EEEUoMgroup22/Group-22/Meeting Minutes/Semester 1/WhatsApp Image 2018-10-06 at 21.18.59.jpeg

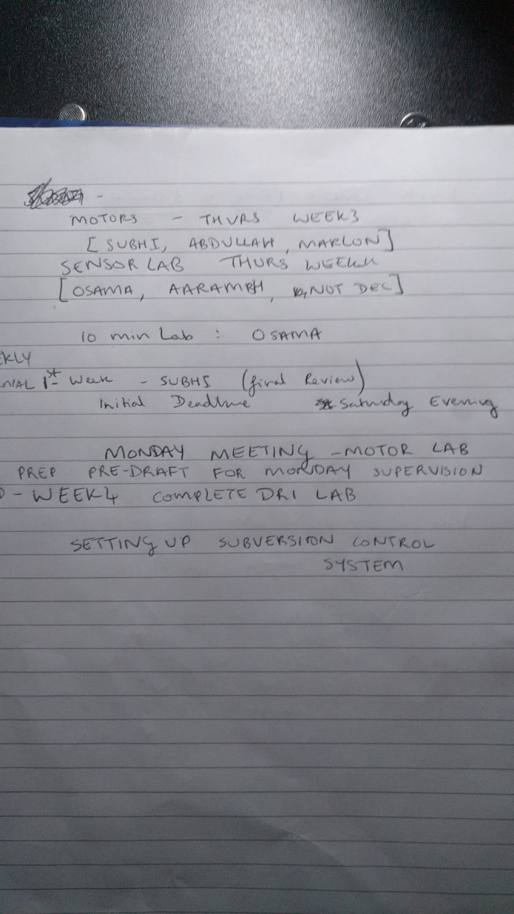
Meeting Minutes/Semester 1/WhatsApp Image 2018-10-06 at 21.18.59.jpeg
