EEEUoMgroup22/Group-22/Design Report 1/Final Draft/Sections Templates/Marlon and Aarambh/Graphs%20(1).xlsx

Sheet: I vs V
N | I | V
1 | 1.31 | 3.119
2 | 1.16 | 2.843
3 | 1.09 | 2.618
4 | 0.91 | 2.453
5 | 0.8 | 2.242
6 | 0.7 | 2.01
7 | 0.61 | 1.82
8 | 0.52 | 1.61
9 | 0.44 | 1.409
10 | 0.36 | 1.213
11 | 0.31 | 1.03
12
13
 | I | V
 | 0.1 | 0.00878
 | 0.2 | 0.019
 | 0.3 | 0.02797
 | 0.4 | 0.037
 | 0.5 | 0.04743
 | 0.6 | 0.05698
 | 0.7 | 0.0643
 | 0.8 | 0.07534
 | 0.9 | 0.08351
 | 1 | 0.09265

Sheet: T vs I, T vs spd and Emf vs spd
N | Motor current I(A) | F1(N) | F2(N) | Voltage V at the motor (V) | Motor speed (rpm) | Torque (Nm) T=(F1-F2)x0.5d | Motor emf (V) E=V-Vb-IxR | d (m) | Vb (V) | R (Ω) | Motor speed (rps)
1 | 1.31 | 2.5 | 0.8 | 3.119 |  | 0.0085 | 3.119 | 0.01 |  |  | 0
2 | 1.16 | 2.1 | 0.7 | 2.843 |  | 0.007 | 2.843 |  |  |  | 0
3 | 1.09 | 2.1 | 0.7 | 2.618 |  | 0.007 | 2.618 |  |  |  | 0
4 | 0.91 | 1.7 | 0.6 | 2.453 |  | 0.0055 | 2.453 |  |  |  | 0
5 | 0.8 | 1.7 | 0.6 | 2.242 |  | 0.0055 | 2.242 |  |  |  | 0
6 | 0.7 | 1.3 | 0.5 | 2.01 |  | 0.004 | 2.01 |  |  |  | 0
7 | 0.61 | 1.1 | 0.4 | 1.82 |  | 0.0035 | 1.82 |  |  |  | 0
8 | 0.52 | 1 | 0.4 | 1.61 |  | 0.003 | 1.61 |  |  |  | 0
9 | 0.44 | 0.8 | 0.35 | 1.409 |  | 0.00225 | 1.409 |  |  |  | 0
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
