EEEUoMgroup22/Group-22/Design Report 1/Final Draft/Sections Templates/Marlon and Aarambh/Graphs.xlsx

Sheet: I vs V
N | I | V | 0.2
1 | 0.34 | 0.956
2 | 0.44 | 1.243
3 | 0.55 | 1.497
4 | 0.66 | 1.748
5 | 0.76 | 2.028
6 | 0.86 | 2.257
7 | 0.99 | 2.546
8 | 1.1 | 2.73
9 | 1.19 | 3.053
10 | 1.28 | 3.247
11 | 1.37 | 3.517
12
13

Sheet: T vs I, T vs spd and Emf vs spd
N | Motor current I(A) | F1(N) | F2(N) | Voltage V at the motor (V) | Motor speed (rpm) | Torque (Nm) T=(F1-F2)x0.5d | Motor emf (V) E=V-Vb-IxR | d (m) | Vb (V) | R (Ω) | Motor speed (rps)
1 | 0.14 | 0 | 0 | 5 | 4890 | 0 | 4.504246 | 0.01 | 0.1568 | 2.4211 | 512.0796025
2 | 0.24 | 0.2 | 0 | 5 | 4656 | 0.001 | 4.262136 |  |  |  | 487.5751798
3 | 0.35 | 0.4 | 0 | 5 | 4300 | 0.002 | 3.995815 |  |  |  | 450.294947
4 | 0.49 | 0.6 | 0 | 5 | 3947 | 0.003 | 3.656861 |  |  |  | 413.3288735
5 | 0.62 | 0.8 | 0 | 5 | 3642 | 0.004 | 3.342118 |  |  |  | 381.3893481
6 | 0.69 | 1 | 0 | 5 | 3582 | 0.005 | 3.172641 |  |  |  | 375.1061628
7 | 0.84 | 1.2 | 0 | 5 | 3220 | 0.006 | 2.809476 |  |  |  | 337.1976115
8 | 1.02 | 1.4 | 0 | 5 | 2776 | 0.007 | 2.373678 |  |  |  | 290.7020402
9 | 1.12 | 1.6 | 0 | 5 | 2546 | 0.008 | 2.131568 |  |  |  | 266.6164965
10 | 1.23 | 1.8 | 0 | 5 | 2221 | 0.009 | 1.865247 |  |  |  | 232.5825761
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
