EEEUoMgroup22/Group-22/Meeting Minutes/Semester 1/WhatsApp Image 2018-10-15 at 13.46.34.jpeg

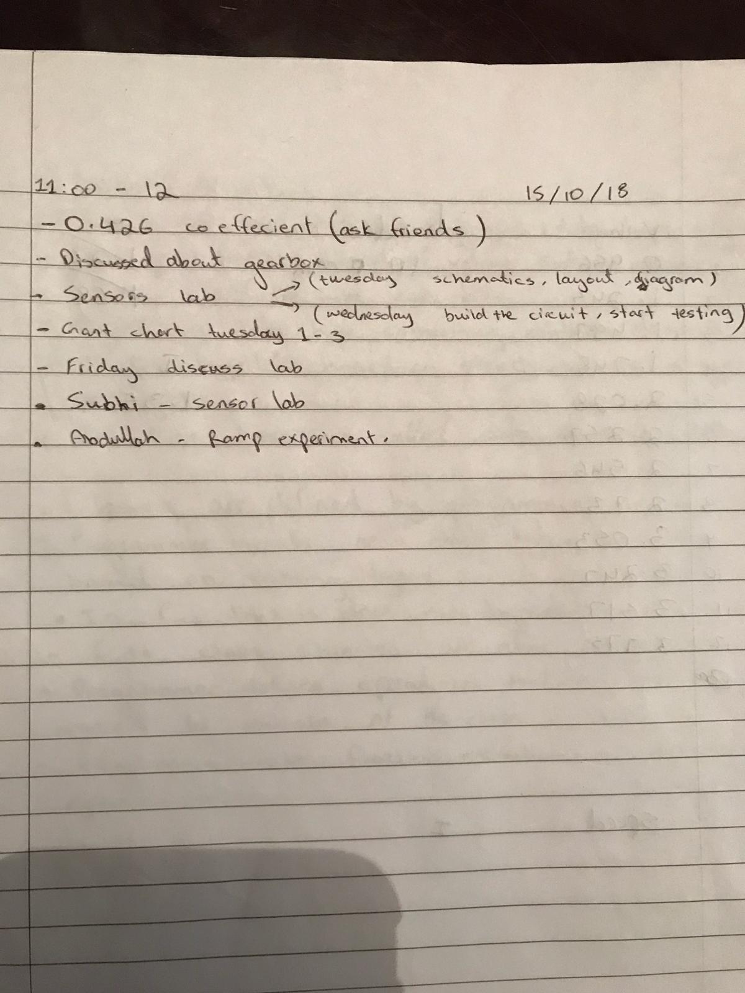
Meeting Minutes/Semester 1/WhatsApp Image 2018-10-15 at 13.46.34.jpeg
