EEEUoMgroup22/Group-22/Meeting Minutes/Semester 1/WhatsApp Image 2018-10-22 at 21.10.34.jpeg

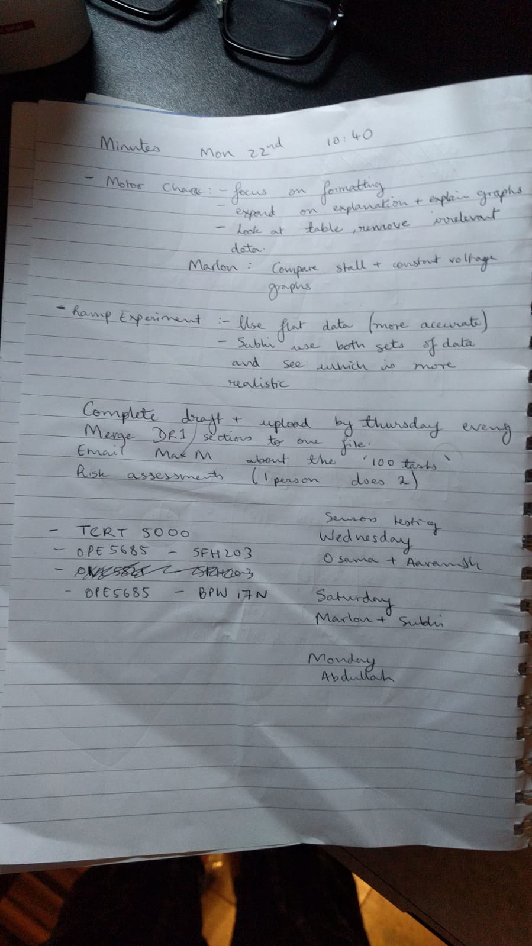
Meeting Minutes/Semester 1/WhatsApp Image 2018-10-22 at 21.10.34.jpeg
