EEEUoMgroup22/Group-22/Meeting Minutes/Semester 1/WhatsApp Image 2018-10-26 at 12.54.49.jpeg

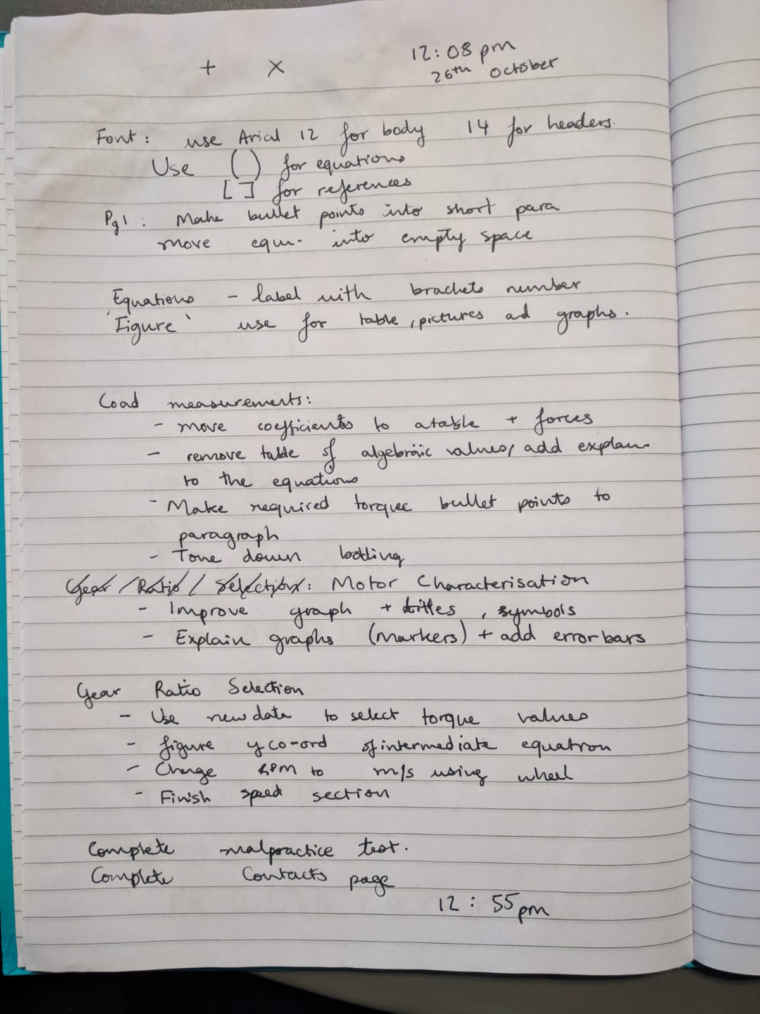
Meeting Minutes/Semester 1/WhatsApp Image 2018-10-26 at 12.54.49.jpeg
