EEEUoMgroup22/Group-22/Meeting Minutes/Semester 1/WhatsApp Image 2018-10-29 at 18.27.18.jpeg

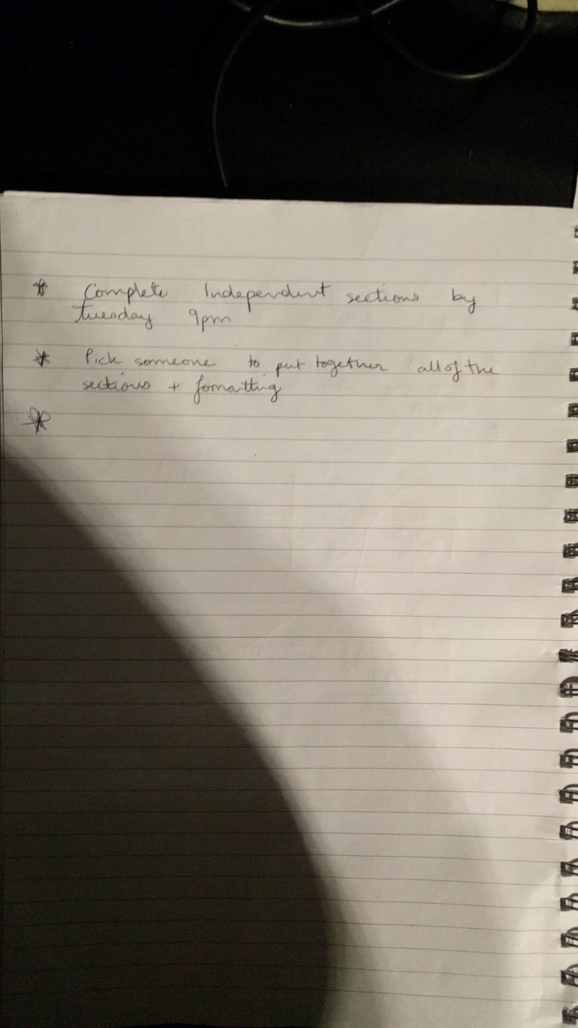
Meeting Minutes/Semester 1/WhatsApp Image 2018-10-29 at 18.27.18.jpeg
