EEEUoMgroup22/Group-22/Meeting Minutes/Semester 1/WhatsApp Image 2018-10-31 at 15.00.20.jpeg

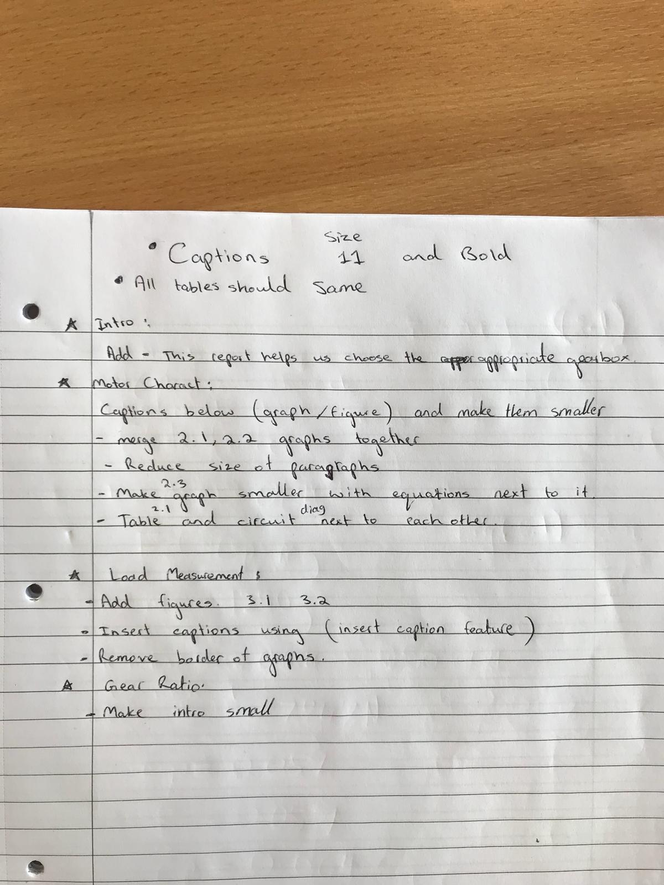
Meeting Minutes/Semester 1/WhatsApp Image 2018-10-31 at 15.00.20.jpeg
