EEEUoMgroup22/Group-22/Meeting Minutes/Semester 1/WhatsApp Image 2018-11-04 at 10.54.24.jpeg

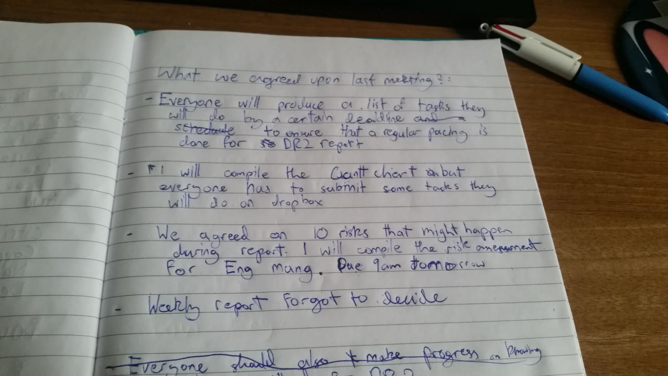
Meeting Minutes/Semester 1/WhatsApp Image 2018-11-04 at 10.54.24.jpeg
