EEEUoMgroup22/Group-22/Meeting Minutes/Semester 1/WhatsApp Image 2018-11-05 at 19.45.11.jpeg

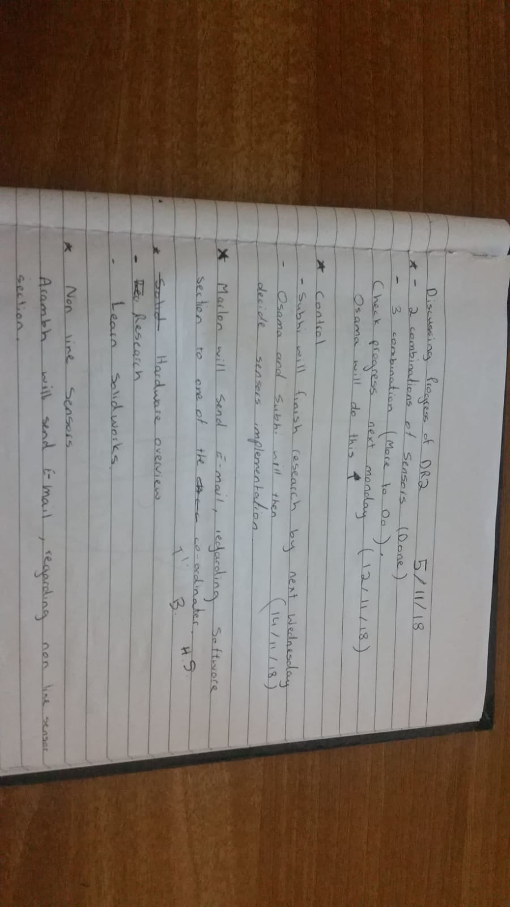
Meeting Minutes/Semester 1/WhatsApp Image 2018-11-05 at 19.45.11.jpeg
