EEEUoMgroup22/Group-22/Meeting Minutes/Semester 1/WhatsApp Image 2018-11-17 at 12.28.48.jpeg

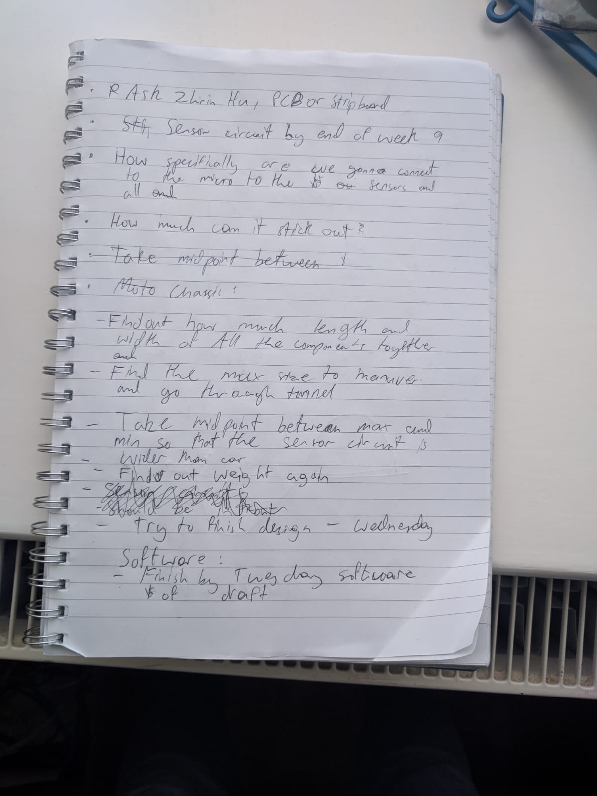
Meeting Minutes/Semester 1/WhatsApp Image 2018-11-17 at 12.28.48.jpeg
