EEEUoMgroup22/Group-22/Meeting Minutes/Semester 1/WhatsApp Image 2018-11-23 at 21.00.41.jpeg

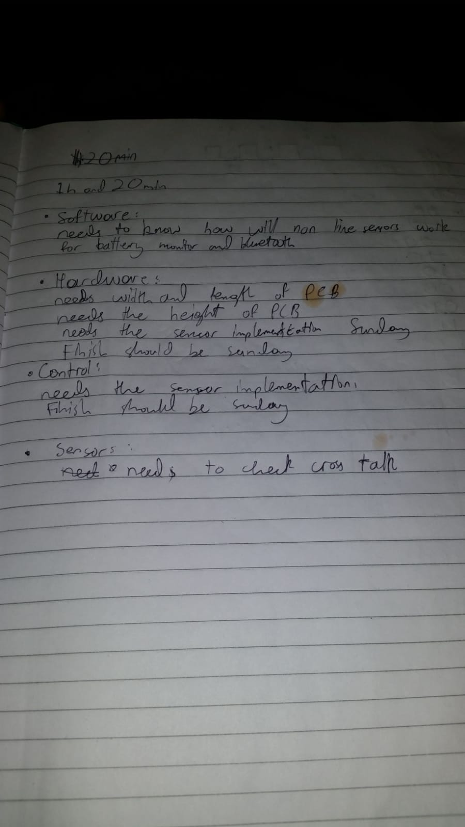
Meeting Minutes/Semester 1/WhatsApp Image 2018-11-23 at 21.00.41.jpeg
