EEEUoMgroup22/Group-22/Meeting Minutes/Semester 1/WhatsApp Image 2018-11-25 at 00.08.05.jpeg

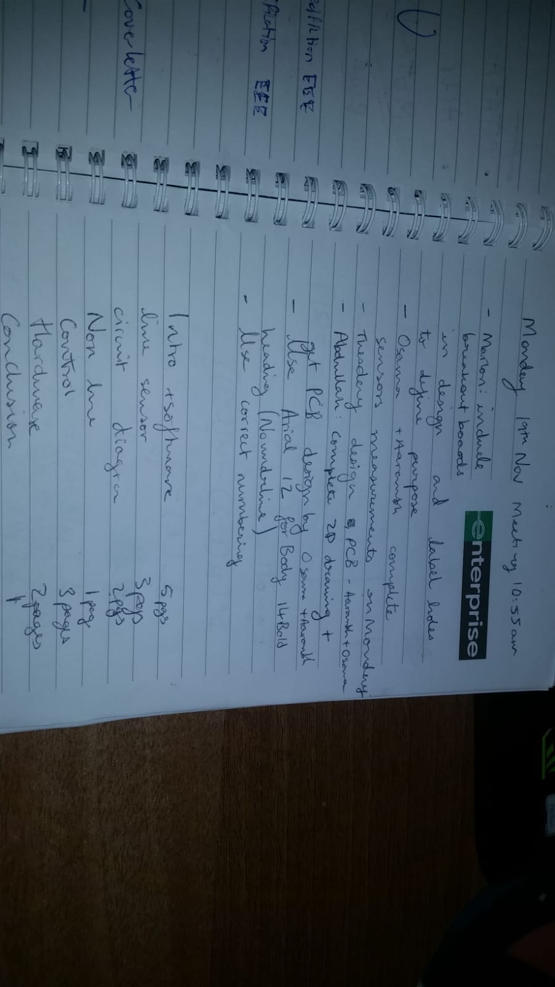
Meeting Minutes/Semester 1/WhatsApp Image 2018-11-25 at 00.08.05.jpeg
