EEEUoMgroup22/Group-22/Meeting Minutes/Semester 1/WhatsApp Image 2018-12-02 at 17.14.09.jpeg

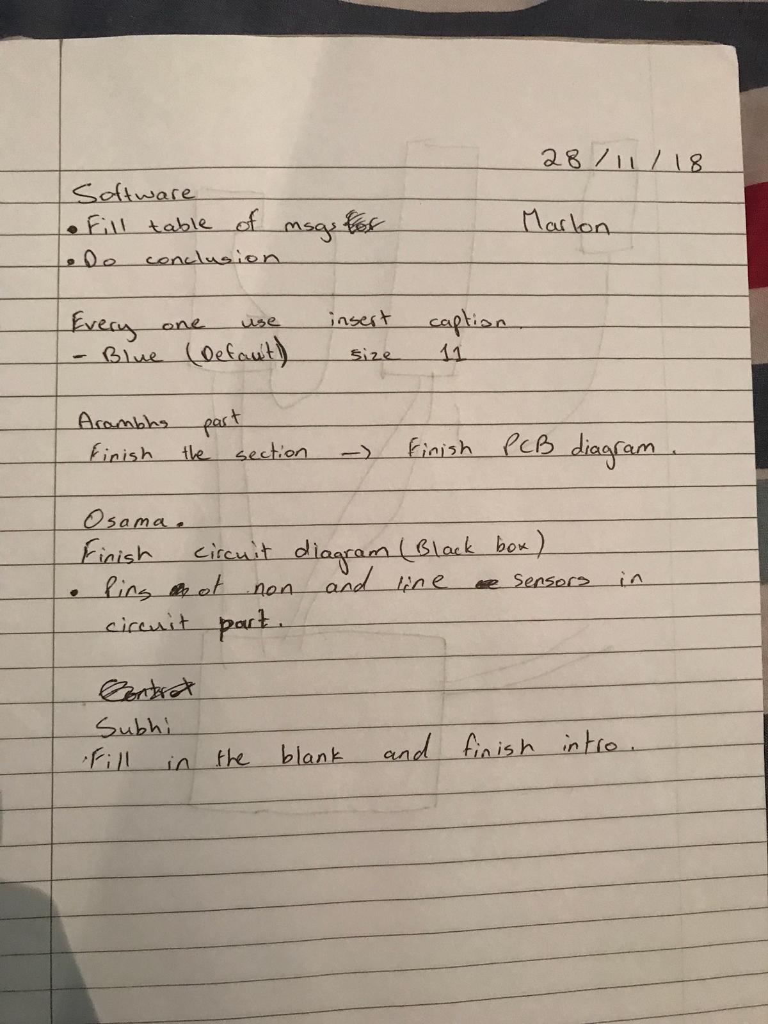
Meeting Minutes/Semester 1/WhatsApp Image 2018-12-02 at 17.14.09.jpeg
