EEEUoMgroup22/Group-22/Meeting Minutes/Semester 2/20190131_141448.jpg

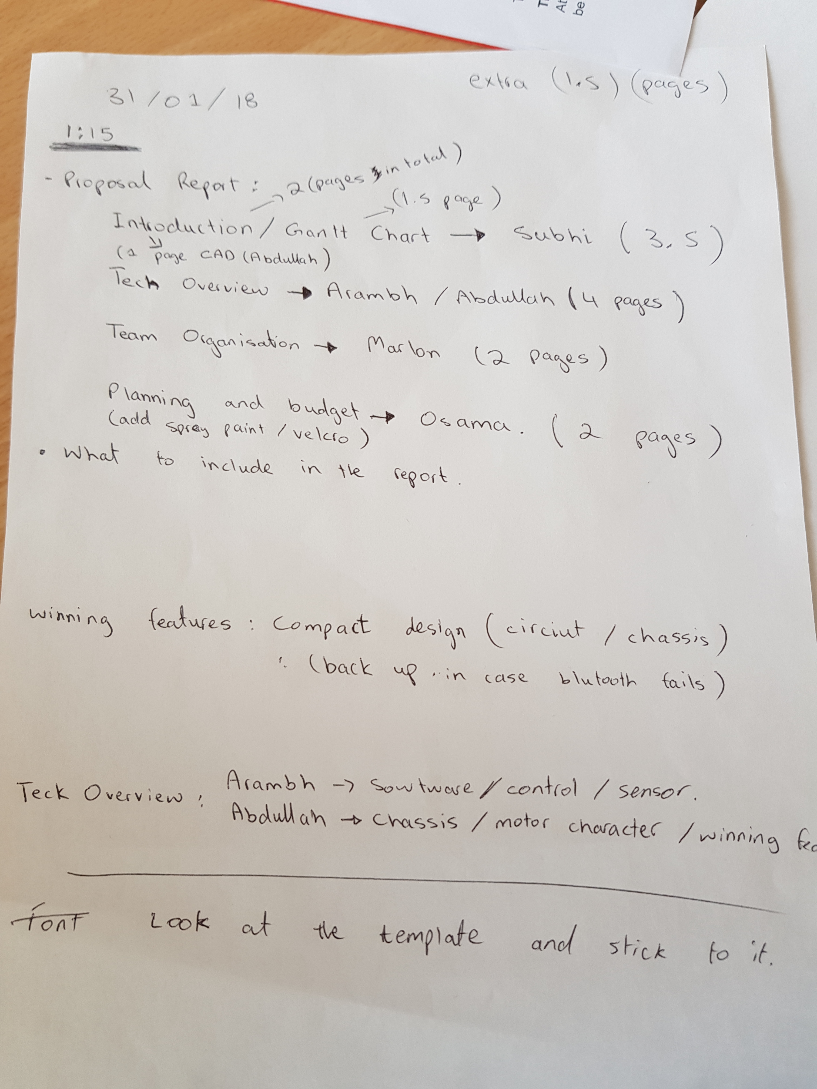
Meeting Minutes/Semester 2/20190131_141448.jpg
