EEEUoMgroup22/Group-22/Meeting Minutes/Semester 2/20190204_115247.jpg

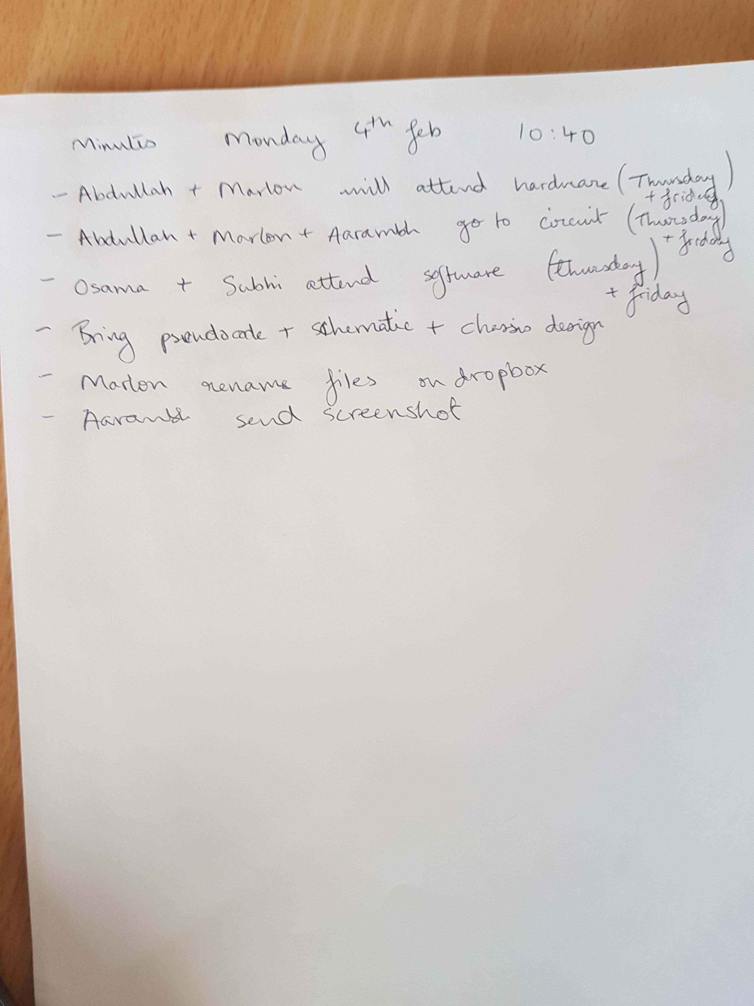
Meeting Minutes/Semester 2/20190204_115247.jpg
