EEEUoMgroup22/Group-22/Other documents/people who won buggy race.PNG

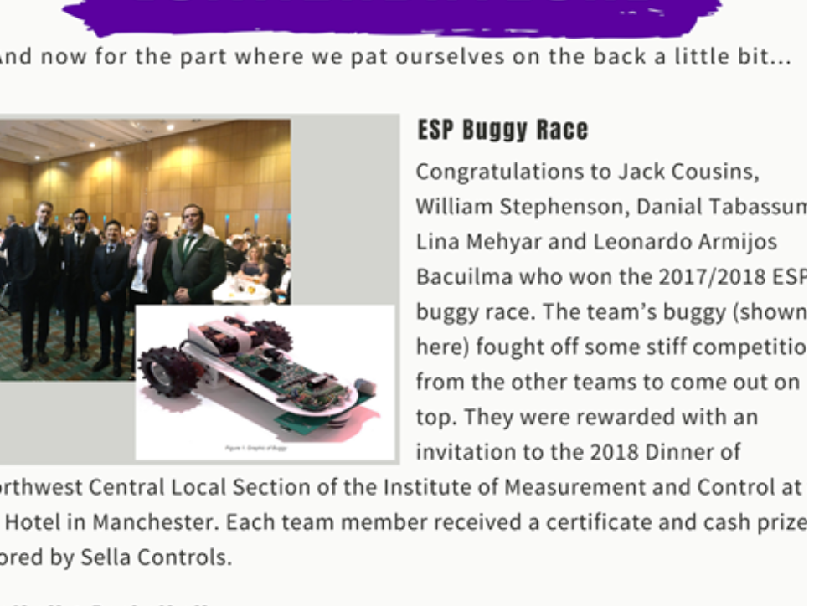
Other documents/people who won buggy race.PNG
