EEEUoMgroup22/Group-22/Technical Datasheets/HM-10_Circuit_001_800-595x400.jpg

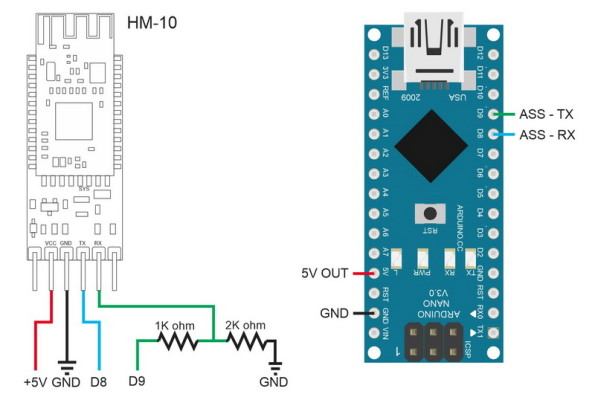
Technical Datasheets/HM-10_Circuit_001_800-595x400.jpg
