EEEUoMgroup22/Group-22/Proposal Report/Budget for Proposal.xlsx

Item category | Item Manu. Part | Quantity needed | Cost per component (£) | Difference between total cost and budget given | sum total
Populated PCB | NUCLEO -F401RE | 1 | 15 | 15
 | Controller board | 1 | 30 | 30
Integrated Circuits | LM339 | 1 | 0.64 | 0.64
 | ULN2003 | 1 | 0.23 | 0.23
Unpopulated PCBs, IC Sockets and Headers | 8 pin IC base | 3 | 0.8 | 2.4
 | 4 way SIL Header | 6 | 0.2 | 1.2
 | Sensor Mini PCBs | 3 | 1 | 3
Sensors | TCRT5000 | 2 | 0.64 | 1.28
 | AEAT-601BF06 | 2 | 16.85 | 33.7
 | HM-10 | 1 | 16.36 | 16.36
Mechanical Parts | Chassis | 1 | 42 | 42
 | Front wheel | 1 | 2.5 | 2.5
 | Rubber tyre | 2 | 1.45 | 2.9
 | Motor B | 2 | 7.11 | 14.22
 | Gear Box | 2 | 7 | 14
 | Jumper cables | 1 | 3 | 3
 | Sensor PCB empty board | 1 | 50 | 50
Misc | Battery Holder | 1 | 3.5 | 3.5
 | Cable ties | 3 | 0.2 | 0.6
 | Batteries | 8 | 2 | 16
Basic electronic parts | resistors | 12 | 0.1 | 1.2
 | Var. resistor | 1 | 0.12 | 0.12 | 253.85
Sensors | TCRT5000 | 4 | 0.64 | 2.56
Unpopulated PCBs, IC Sockets and Headers | 8 pin IC base | 3 | 0.8 | 2.4
 | 4 way SIL Header | 10 | 0.2 | 2
 | Sensor Mini PCBs | 3 | 1 | 3
Integrated circuits | LM339 | 1 | 0.64 | 0.64 | 10.6
 |  |  |  | Total Cost | 264.45
