EEEUoMgroup22/Group-22/proposal/Budget for Proposal.xlsx

Item category | Item Manu. Part | Item description | Quantity needed | Cost per component (£) | total cost of component (£) | Total cost of all components(£)
Free Issue
Populated PCB | NUCLEO -F401RE | STM32F401RE Nucleo Dev. | 1 | 15 | 15
 | Controller board | Motor drive board | 1 | 30 | 30
Integrated Circuits | LM339 | Quad comparator | 1 | 0.64 | 0.64
 | ULN2003 | 7 Elemnet Darlington | 1 | 0.23 | 0.23
Unpopulated PCBs, IC Sockets and Headers | 8 pin IC base | 2.54 mm pitch | 3 | 0.8 | 2.4
 | 4 way SIL Header | 2.54 mm ptich | 6 | 0.2 | 1.2
 | Sensor Mini PCBs | Created at UoM | 3 | 1 | 3
Sensors | TCRT5000 | Reflective Optical Sensor | 2 | 0.64 | 1.28
 | AEAT-601BF06 | Broadcom encoders | 2 | 16.85 | 33.7
 | HM-10 | Bluetooth module | 1 | 16.36 | 16.36
Mechanical Parts | Chassis | 600 x 900 x 3 mm Acetyl Created at UoM | 1 | 42 | 42
 | Front wheel | Ball castor | 1 | 2.5 | 2.5
 | Rubber tyre | 80 mm spiked tyre | 2 | 1.45 | 2.9
 | Motor A | 6-15V 8W DC Brushed |  | 5.14 | 0
 | Motor B | RS Pro DC Motor |  | 7.11 | 0
 | Gear Box | Acetyl box+ gears | 2 | 7 | 14
 | Jumper cables | MM/MF/FF | 1 | 3 | 3
 | Sensor PCB empty board | dimensions | 1 |  | 0
Misc | Battery Holder | Custom with fuse, 8 way | 1 | 3.5 | 3.5
 | Batteries | 1.2V rechargable | 8 | 2 | 16
Basic electronic parts | resistors | Leaded resistors | 12 | 0.1 | 1.2
 | Var. resistor | Variable resistor | 1 | 0.12 | 0.12 | 189.03
Budget
Sensors | TCRT5000 | Reflective Optical Sensor | 3 | 0.64 | 1.92
Unpopulated PCBs, IC Sockets and Headers | 8 pin IC base | 2.54 mm pitch | 3 | 0.8 | 2.4
 | 4 way SIL Header | 2.54 mm ptich | 10 | 0.2 | 2
 | Sensor Mini PCBs | Created at UoM | 3 | 1 | 3
Integrated circuits | LM339 | Quad comparator | 1 | 0.64 | 0.64
Misc | Velcro Order code OE04216 , Onecall | Velcro 12 mm x 380 mm | 1 | 3.05 | 3.05 | 13.01
 | order code 9731180 |  |  |  |  | 202.04
