EEEUoMgroup22/Group-22/Measurements/Sensors Methods and Results/Sensors results/bpw - ope final measurements.xlsx

Sheet: Height experiments
For black part | Distance (mm) | Resistor LED (ohm) | Resistor Trans (ohm) | Voltage Res LED (V) | Voltage VDD LED (V) | Current LED (A) | Voltage Res Trans (V) | Voltage Collector Emitter VDD (V) | Current Trans (A) | Power (W) | Wasted Power (W) | Overall Efficiency | Technical results
1 | -2 | 33 | 100000 | 3 | 2 | 0.06060606061 |  | 5 | 0 | 0.303030303 | 0.1212121212 | 60 | Height of Transistor from stripboard | 0 | Column1
2 | 3 | 33 | 100000 | 3 | 2 | 0.06060606061 | 0.0864 | 4.9136 | 8.64e-07 | 0.303034623 | 0.1212121959 | 60.0005456 | Height of first increment | 16mm | 16mm
3 | 8 | 33 | 100000 | 3 | 2 | 0.06060606061 | 0.464 | 4.536 | 4.64e-06 | 0.303053503 | 0.1212142742 | 60.00235174 | Each increment | 5mm | 5mm
4 | 13 | 33 | 100000 | 3 | 2 | 0.06060606061 | 0.395 | 4.605 | 3.95e-06 | 0.303050053 | 0.1212136815 | 60.00209198
5 | 18 | 33 | 100000 | 3 | 2 | 0.06060606061 | 0.327 | 4.673 | 3.27e-06 | 0.303046653 | 0.1212131905 | 60.00180524 | LED | Column2 | Column3
6 | 23 | 33 | 100000 | 3 | 2 | 0.06060606061 | 0.253 | 4.747 | 2.53e-06 | 0.303042953 | 0.1212127613 | 60.00145851 | Voltage VDD LED (V)
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
