EEEUoMgroup22/Group-22/Measurements/Sensors Methods and Results/Sensors results/compiled sensors data.xlsx

Sheet: Sheet1
Height Measurements | OVL5521 - VT90N2 at 10,000 at black | OVL5521 - VT90N2 at 10,000 at white |  | TCRT5000 4K7 | TCRT WHITE |  | OPE VTN black |  | OPE5685 SFH BLACK | OPE SFH WHITE | OPE BPW |  | TCRT10K |  | tcrt black min | tcrt black max |  |  |  |  | TCRT5000 CROSSTALK BLACK
0 | 1.274 | 3.1 |  | 0.0053 | 0.433 |  | 1.948 | 3.205 | 0.813 | 4.91 | 0.0864 | 1.424 |  |  |  |  |  |  | negative | positive | 0.0727 | 2.72
4 | 2.12 | 4.2 |  | 0.06 | 4 |  | 1.868 | 3.249 | 0.646 | 4.91 | 0.464 | 4.42 | 0.94444 | 4.42476 | 0.9364 | 0.954 | 4.4244 | 4.425 | 0.00828 | 0.00992 | 0.1456 | 4.398
9 | 2.27 | 4.1 |  | 0.095 | 3.74 |  | 2.0827 | 3.413 | 0.499 | 4.64 | 0.395 | 4.26 | 0.431786 | 4.3825 | 0.42918 | 0.4331 | 4.3822 | 4.3827 | 0.002806 | 0.001614 | 0.04957 | 2.4702
14 | 1.98 | 3.96 |  | 0.0267 | 1.4 |  | 2.717 | 3.315 | 0.436 | 3.04 | 0.327 | 3.51 | 0.2273 | 3.23758 | 0.2246 | 0.2283 | 3.219 | 3.2476 | 0.01272 | 0.01958 | 0.01949 | 1.011
19 | 2.4 | 3.82 |  | 0.01 | 0.565 |  | 2.831 | 3.268 | 0.404 | 2.05 | 0.253 | 2.64 | 0.14142 | 1.90036 | 0.1406 | 0.1421 | 1.8905 | 1.9103 | 0.01076 | 0.01054 | 0.0111 | 0.4804
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
