EEEUoMgroup22/Group-22/Measurements/Sensors Methods and Results/Sensors results/ope5685 and vtn final measurements (2) completed.xlsx

Sheet: Height experiments
For black part | Distance (mm) | Resistor LED (ohm) | Resistor Trans (ohm) | Voltage Res LED (V) | Voltage VDD LED (V) | Current LED (A) | Voltage Res Trans (V) | Voltage Collector Emitter VDD (V) | Current Trans (A) | Power (W) | Wasted Power (W) | Overall Efficiency | Technical results
 | 0 | 33 | 8170 | 3.1386 | 1.8614 | 0.05640606061 |  | 3.132 | 0.0002286413709 | 0.2831735099 | 0.1054213433 | 62.7714671 | Height of Transistor from stripboard | 0 | Column1
 | 1 | 33 | 8170 | 3.1386 | 1.8614 | 0.05640606061 | 1.948 | #REF! | #REF! | #REF! | #REF! | #REF! | Height of first increment | 16mm | 16mm
 | 6 | 33 | 8170 | 3.1386 | 1.8614 | 0.05640606061 | 1.868 | 2.9173 | 0.0002549204406 | 0.2833049052 | 0.105525164 | 62.75208722 | Each increment | 5mm | 5mm
 | 11 | 33 | 8170 | 3.1386 | 1.8614 | 0.05640606061 | 2.0827 | 2.283 | 0.0003325581395 | 0.2836930937 | 0.1058978017 | 62.67170262
 | 16 | 33 | 8170 | 3.1386 | 1.8614 | 0.05640606061 | 2.717 | 2.169 | 0.0003465116279 | 0.2837628612 | 0.1059752156 | 62.65359914 | LED | Column2 | Column3
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
