EEEUoMgroup22/Group-22/Measurements/Sensors Methods and Results/Sensors results/OPE5685 SFH203 FINAL MEASUREMENTS.xlsx

Sheet: Height experiments
For black part | Distance from transistor to black plate (mm) | Resistor LED (ohm) | Resistor Trans (ohm) | Voltage Res LED (V) | Voltage VDD LED (V) | Current LED (A) | Voltage Res Trans (V) | Voltage Collector Emitter VDD (V) | Current Trans (A) | Power (W) | Wasted Power (W) | Overall Efficiency | Technical results
 | -3 | 33 | 470000 | 3.1 | 1.9 | 0.05757575758 |  | 5 | 0 | 0.2878787879 | 0.1093939394 | 62 | Height of Transistor from stripboard | 0 | Column1
 | 4 | 33 | 470000 | 3.1 | 1.9 | 0.05757575758 | 0.813 | 4.187 | 1.729787234e-06 | 0.2878874368 | 0.1093953457 | 62.00065313 | Height of first increment | 16mm | 16mm
 | 9 | 33 | 470000 | 3.1 | 1.9 | 0.05757575758 | 0.646 | 4.354 | 1.374468085e-06 | 0.2878856602 | 0.1093948273 | 62.0005987 | Each increment | 5mm | 5mm
 | 14 | 33 | 470000 | 3.1 | 1.9 | 0.05757575758 | 0.499 | 4.501 | 1.061702128e-06 | 0.2878840964 | 0.1093944692 | 62.00051668
 | 19 | 33 | 470000 | 3.1 | 1.9 | 0.05757575758 | 0.436 | 4.564 | 9.276595745e-07 | 0.2878834262 | 0.1093943439 | 62.00047175 | LED | Column2 | Column3
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
