EEEUoMgroup22/Group-22/Measurements/Sensors Methods and Results/Sensors results/OVL -vt90n2.xlsx

Sheet: Height experiments
For black part | Distance (mm) | Resistor LED (ohm) | Resistor Trans (ohm) | Voltage Res LED (V) | Voltage VDD LED (V) | Current LED (A) | Voltage Res Trans (V) | Voltage Collector Emitter VDD (V) | Current Trans (A) | Power (W) | Wasted Power (W) | Overall Efficiency | Technical results
 | 0 | 62 | 10000 | 1.81 |  |  |  |  | 0 | 0 | 0 | #DIV/0! | Height of Transistor from stripboard | 0 | Column1
 | 4 | 62 | 10000 | 1.81 |  |  |  |  | 0 | 0 | 0 | #DIV/0! | Height of first increment | 16mm | 16mm
 | 9 | 62 | 10000 | 1.81 | 3.19 | 0.02919354839 | 1.274 | 3.726 | 0.0001274 | 0.1466047419 | 0.05300263018 | 63.84657858 | Each increment | 5mm | 5mm
 | 14 | 62 | 10000 | 1.81 | 3.19 | 0.02919354839 | 2.12 | 2.88 | 0.000212 | 0.1470277419 | 0.05328976258 | 63.75530095
 | 19 | 62 | 10000 | 1.81 | 3.19 | 0.02919354839 | 2.27 | 2.73 | 0.000227 | 0.1471027419 | 0.05335561258 | 63.7290156 | LED | Column2 | Column3
 | 24 | 62 | 10000 | 1.81 | 3.19 | 0.02919354839 | 1.98 | 3.02 | 0.000198 | 0.1469577419 | 0.05323236258 | 63.77709546 | Voltage VDD LED (V) | 5
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
