EEEUoMgroup22/Group-22/Measurements/Sensors Methods and Results/Sensors results/TCRT5000 10KCOMPLETED.xlsx

Sheet: height black
Distance (mm) | Resistor LED (ohm) | Resistor Trans (ohm) | Voltage Res LED (V) | Voltage LED (V) | Current LED (A) | Voltage Res Trans (V) | Voltage Collector Emitter (V) | Current Trans (A) | Power (W) | Wasted Power (W) | Overall Efficiency | white line | Voltage Res Trans (V) | Voltage Collector Emitter (V) | Current Trans (A) | Power (W) | Wasted Power (W) | Overall Efficiency | dark voltage of resistor | dark current | background illum voltage | background illum current
0 | 100 | 10000 | 3.5 | 1.5 | 0.035 | 0.0053 | 4.9947 | 5.3e-07 | 0.17500265 | 0.1225000028 | 30.00105838 |  | 0.433 | 4.567 | 4.33e-05 | 0.0002165 | 3.281107185e-10 | 99.99984845 | 0.034 | 3.4e-06 | 0.045 | 4.5e-06
4 | 100 | 10000 | 3.5 | 1.5 | 0.035 | 0.0457 | 4.9543 | 4.57e-06 | 0.17502285 | 0.1225002088 | 30.00901948 | (second increment) | 2.54 | 2.46 | 0.000254 | #VALUE! | #VALUE! | #VALUE!
9 | 100 | 10000 | 3.5 | 1.5 | 0.035 | 0.57 | 4.43 | 5.7e-05 | 0.175285 | 0.12253249 | 30.09527912 |  | 2.7 | 2.3 | 0.00027 | 0.00135 | 1.27782765e-08 | 99.99905346
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
