EEEUoMgroup22/Group-22/Measurements/Sensors Methods and Results/Sensors results/TCRT5000 14mm error bars.xlsx

Sheet: Height experiments
For black part | Distance (mm) | Resistor LED (ohm) | Resistor Trans (ohm) | Voltage Res LED (V) | Voltage VDD LED (V) | Current LED (A) | Voltage Res Trans (V) | Voltage Collector Emitter VDD (V) | Current Trans (A) | Power (W) | Wasted Power (W) | Overall Efficiency | Technical results
 | 0 |  |  |  | 5 | #DIV/0! |  | 5 | #DIV/0! | #DIV/0! | #DIV/0! | #DIV/0! | Height of Transistor from stripboard | 0 | Column1
 | 4 |  |  |  | 5 | #DIV/0! |  | 5 | #DIV/0! | #DIV/0! | #DIV/0! | #DIV/0! | Height of first increment | 16mm | 16mm
 | 9 |  |  |  | 5 | #DIV/0! |  | 5 | #DIV/0! | #DIV/0! | #DIV/0! | #DIV/0! | Each increment | 5mm | 5mm
 | 14 |  |  |  | 5 | #DIV/0! |  | 5 | #DIV/0! | #DIV/0! | #DIV/0! | #DIV/0!
 | 19 |  |  |  | 5 | #DIV/0! |  | 5 | #DIV/0! | #DIV/0! | #DIV/0! | #DIV/0! | LED | Column2 | Column3
 | 24 |  |  |  | 5 | #DIV/0! |  | 5 | #DIV/0! | #DIV/0! | #DIV/0! | #DIV/0! | Voltage VDD LED (V)
 | 29 |  |  |  | 5 | #DIV/0! |  | 5 | #DIV/0! | #DIV/0! | #DIV/0! | #DIV/0! | Voltage Of LED resistor
 | 34 |  |  |  | 5 | #DIV/0! |  | 5 | #DIV/0! | #DIV/0! | #DIV/0! | #DIV/0! | Voltage Of LED resistor
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
