EEEUoMgroup22/Group-22/Measurements/Sensors Methods and Results/Sensors results/TCRT5000 4k7 line spread.xlsx

Sheet: Height experiments
For black part | Distance (mm) | Resistor LED (ohm) | Resistor Trans (ohm) | Voltage Res LED (V) | Voltage VDD LED (V) | Current LED (A) | Voltage Res Trans (V) | Voltage Collector Emitter VDD (V) | Current Trans (A) | Power (W) | Wasted Power (W) | Overall Efficiency | Technical results
 | 0 | 100 | 4700 | 3.39 | 1.61 | 0.0339 | 0.0053 | 4.9947 | 1.127659574e-06 | 0.1695056383 | 0.114921006 | 32.20225172 | Height of Transistor from stripboard | 0 | Column1
 | 4 | 100 | 4700 | 3.39 | 1.61 | 0.0339 | 0.06 | 4.94 | 1.276595745e-05 | 0.1695638298 | 0.114921766 | 32.22507058 | Height of first increment | 16mm | 16mm
 | 9 | 100 | 4700 | 3.39 | 1.61 | 0.0339 | 0.095 | 4.905 | 2.021276596e-05 | 0.1696010638 | 0.1149229202 | 32.23926925 | Each increment | 5mm | 5mm
 | 14 | 100 | 4700 | 3.39 | 1.61 | 0.0339 | 0.0267 | 4.9733 | 5.680851064e-06 | 0.1695284043 | 0.1149211517 | 32.21127033
 | 19 | 100 | 4700 | 3.39 | 1.61 | 0.0339 | 0.01 | 4.99 | 2.127659574e-06 | 0.1695106383 | 0.1149210213 | 32.2042425 | LED | Column2 | Column3
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
