EEEUoMgroup22/Group-22/Measurements/Sensors Methods and Results/Sensors results/TCRT5000 CROSSTALK.xlsx

Sheet: Height experiments
For black part | Distance (mm) | Resistor LED (ohm) | Resistor Trans (ohm) | Voltage Res LED (V) | Voltage VDD LED (V) | Current LED (A) | Voltage Res Trans (V) | Voltage Collector Emitter VDD (V) | Current Trans (A) | Power (W) | Wasted Power (W) | Overall Efficiency | TRANSISTOR 2 VOLTAGE | Technical results
 | 0 | 100 | 10000 | 3.348 | 1.252 | 0.03348 | 0.0727 | 4.9273 | 7.27e-06 | 0.16743635 | 0.1120915685 | 33.05422118 |  | Height of Transistor from stripboard | 0 | Column1
 | 4 | 100 | 10000 | 3.348 | 1.252 | 0.03348 | 0.1456 | 4.8544 | 1.456e-05 | 0.1674728 | 0.1120931599 | 33.0678415 |  | Height of first increment | 16mm | 16mm
 | 9 | 100 | 10000 | 3.348 | 1.252 | 0.03348 | 0.04957 | 4.95043 | 4.957e-06 | 0.167424785 | 0.1120912857 | 33.04976577 |  | Each increment | 5mm | 5mm
 | 14 | 100 | 10000 | 3.348 | 1.252 | 0.03348 | 0.01949 | 4.98051 | 1.949e-06 | 0.167409745 | 0.112091078 | 33.04387508
 | 19 | 100 | 10000 | 3.348 | 1.252 | 0.03348 | 0.0111 | 4.9889 | 1.11e-06 | 0.16740555 | 0.1120910523 | 33.04221257 |  | LED | Column2 | Column3
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
