EEEUoMgroup22/Group-22/Measurements/Motors and Gearbox Results/results 2ND force measurement.xlsx

weight (N) | Flat:stationary (N) | Flat: constant speed (N) | Ramp: stationary (N) | Ramp: constant speed (N) | cofficient of static friction: flat stationary | cofficent of rolling friction flat constant | Ramp: static friction cofficient | Ramp: rolling friction cofficient | estimated ramp force using stationary (N) | estimated ramp force constant (N)
10.5 | 0.6 | 0.5 | 3.5 | 2.8 | 0.057 | 0.0476 | 0.07694639861 | 0.007924274991
15.49 | 0.9 | 0.8 | 6.8 | 4.4 | 0.058 | 0.0516 | 0.1863391123 | 0.02592617166
20.49 | 1.3 | 1.2 | 8.1 | 6.2 | 0.063 | 0.0586 | 0.1411177727 | 0.04511335478
25.49 | 1.7 | 1.5 | 10.5 | 8.5 | 0.067 | 0.0588 | 0.1583161442 | 0.07708178921
30.49 | 2.3 | 2.1 | 12 | 10.5 | 0.075 | 0.0689 | 0.13931306 | 0.08837840007
AVERAGE FRICTION |  |  |  |  | 0.064 | 0.057 | 0.140 | 0.059
TORQUE REQUIRED FOR MASS OF 1217g
standard error in % |  |  |  |  | 0.003316481949 | 0.003629603942 | 0.0179714304 | 0.01436632666
Degree in degrees | 15
Diameter | 8.3 cm
