EEEUoMgroup22/Group-22/Measurements/Motors and Gearbox Results/results from force measurement.xlsx

weight (N) | Flat:stationary (N) |  | Flat: constant speed (N) |  | Ramp: stationary (N) |  | Ramp: constant speed (N) |  | cofficient of static friction: flat stationary | cofficent of rolling friction flat constant | Ramp: static friction cofficient | Ramp: rolling friction cofficient | estimated ramp force using stationary (N) | estimated ramp force constant (N)
5.5 | 0.5 | 0.55 | 0.5 | 0.5 | 3 | 3.1 | 2.2 | 2.2 | 0.100 | 0.0909 | 0.3071511762 | 0.1373164714 | 1.959855771 | 1.906863068
 | 0.6 |  | 0.5 |  | 3.2 |  | 2.2 |  | #DIV/0! | #DIV/0! | #DIV/0! | #DIV/0! | 0 | 0
10.5 | 1.2 | 1.1 | 0.8 | 0.8 | 7 | 7 | 4 | 4 | 0.105 | 0.0762 | 0.4140841386 | 0.1175473523 | 3.741542835 | 3.640374949
 | 1 |  | 0.8 |  | 7 |  | 4 |  | #DIV/0! | #DIV/0! | #DIV/0! | #DIV/0! | 0 | 0
15.5 | 1.3 | 1.35 | 1 | 1.1 | 12 | 12 | 6 | 6 | 0.087 | 0.0710 | 0.5256840043 | 0.1239244875 | 5.5232299 | 5.373886829
 | 1.4 |  | 1.2 |  | 12 |  | 6 |  | #DIV/0! | #DIV/0! | #DIV/0! | #DIV/0! | 0 | 0
20.5 | 1.7 | 1.6 | 2 | 1.85 | 14.5 | 14.5 | 8 | 8 | 0.078 | 0.0902 | 0.4562743317 | 0.127190825 | 7.304916965 | 7.107398709
 | 1.5 |  | 1.7 |  | 14.5 |  | 8 |  | #DIV/0! | #DIV/0! | #DIV/0! | #DIV/0! | 0 | 0
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
