EEEUoMgroup22/Group-22/Measurements/Sensors Methods and Results/my block digram for the sensor circuit.PNG

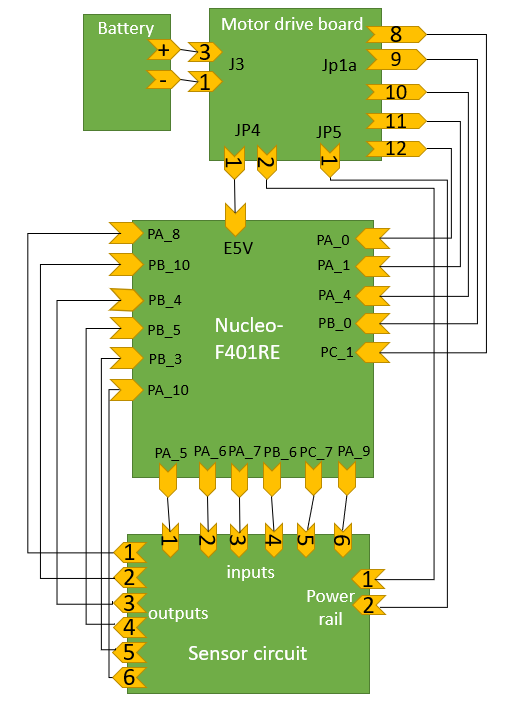
Measurements/Sensors Methods and Results/my block digram for the sensor circuit.PNG
