EEEUoMgroup22/Group-22/Measurements/Sensors Methods and Results/Sensors results/47038477_365895880849488_5616981813374222336_n.jpg

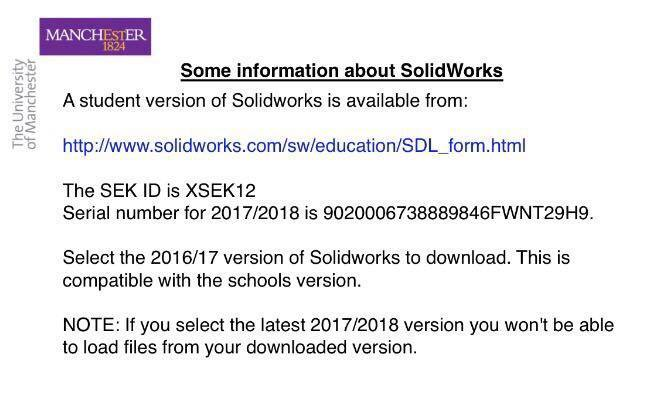
Measurements/Sensors Methods and Results/Sensors results/47038477_365895880849488_5616981813374222336_n.jpg
