EEEUoMgroup22/Group-22/Weekly Journal/Semester 2/Week 5/abdullah week 5.docx

Abdullah Ahmed Akhtar

- Gearbox and wheel were not working properly so got them fixed by taking them to the mechanical workshop.
- Made the edges of the plates smooth as required in Td1.
- Made the wires shorter and arranged wires in organised way.
- Helped Osama with debugging of the code for task 6.
- Prepared for td1 by going through the technical information and did a bit of research for encoders.
