EEEUoMgroup22/Group-22/Weekly Journal/Semester 2/Week 5/Marlon Guanoluisa Week 5.docx

Marlon Guanoluisa:

- Helped Osama with the code of the TD1 for the different tasks which I spent three days of at least 2 hours per day working with the group through the task 6 trying to get a decent square with the buggy and explained what the ports from the motor are for.
- Disassembled and assembled the buggy because it was needed to smooth the sharp edges and made wires shorter, soldered the ends, grouped them together and connected back to the Motor Drive Board and to the microcontroller.
- Prepared for the questions that were going to be assessed in TD1.
