EEEUoMgroup22/Group-22/Weekly Journal/Semester 2/Week 6/Abdullah sem 2 week 6.docx

Abdullah Ahmed Akhtar

- Discussed with group, what implantation to use for sensor circuit and whether to use analogue or digital.
- Desoldered components of the old shipboard to use in the new stripboard as there was shortage of components and university was unable to order new components.
- Worked on the strip board along with Marlon and Aarambh.
- Worked on the Molex connecters (crimping wires and connecting to the headers) required for the sensor circuit along with Marlon.
- Looked at the pcb design completed by Aarambh to ensure there wasn’t any mistake before its sent for printing.
