EEEUoMgroup22/Group-22/Weekly Journal/Semester 2/Week 6/Marlon Guanoluisa Week 6.docx

Marlon Guanoluisa:

- Desoldered all the components from the stripboard because there were some problems trying to connect the sensors to the different ports of the circuit.
- Discussed along with all the group and Liam Marsh about what are the advantages and disadvantages of each implementation for the sensors and from that, it was decided that analog will be implemented because it would be easier to write the coding for our teammates.
- Worked along with Aarambh and Abdulla trying to find the best way to place the components and wire them, as the circuit changes for analog implementation a new design is needed.
