EEEUoMgroup22/Group-22/Weekly Journal/Semester 2/Week 6/Subhi journal wk6.docx

Subhi Alsous:

- As I couldn’t attend TD1 due to sickness, I took the buggy home and spared some time looking at the pin connections mode and looked at the recent code and understood it.
- Regarding the TD2, I was assigned the task of writing the code to read the sensors appropriately.
- I worked on how we could demonstrate the detection of the sensors readings in terms of lighting up relevant LEDs.
- I helped in the decision making of going with analogue control instead of the digital control proposed earlier as it will allow us to implement PID control better.
