EEEUoMgroup22/Group-22/Weekly Journal/Semester 2/Week 7/Abdullah sem 2 week 7.docx

Abdullah Ahmed Akhtar

- Worked on the Molex connecters (crimping wires and connecting to the headers) required for the sensor circuit along with Marlon.
- Soldered components on to the strip board, to complete the sensor circuit.
- Finished the sensor circuit along with Aarambh and Marlon.
- Tested the sensor circuit for any faults, and 2 transistors were not working as expected because we had used wrong resister value, Aarambh then fixed the issue.
