EEEUoMgroup22/Group-22/Weekly Journal/Semester 2/Week 7/Marlon Guanoluisa Week 7.docx

Marlon Guanoluisa:

- Had finished soldering all the components to the stripboard and wired them, now it contains header connectors for analog output, power supply input and Darlington input to control the on/off state of each LED.
- Had tested the sensor stripboard to make sure if all the sensors are working properly and they are.
- Discussed with all members of the group about the manner of how the correct functionality of the sensors will be presented and it was decided that LEDs will be used because there were not enough pins for analog input in the microcontroller when the Application Shield is being used.
