EEEUoMgroup22/Group-22/Weekly Journal/Semester 1/Week 11/Aarambh Sinha.docx

Aarambh Sinha

- Completed the sensors and implementation section of DR2
- Did final proofread and final checks before submission of DR2
- Completed peer review of the rest of the group members.
- Sat the ESP test in Barnes Wallis.
- I will focus on the Technical Overview section with Abdullah. Will cover software design, sensor characterisation and control algorithms selections.
