EEEUoMgroup22/Group-22/Weekly Journal/Semester 1/Week 4/Marlon Guanoluisa Journal Week 4.docx

Marlon Guanoluisa

ID: 10145373

- I have created the first version of the Gantt chart, estimating as good as I could all the dates and the tasks that need to be done.
- I was present in the pre-lab for sensors with all my group trying to find the best combination possible between the resistors for the sensors’ measurement.
- I have been adding more content to the motor characterisation, hopefully, it will be ready by Monday.
