EEEUoMgroup22/Group-22/Weekly Journal/Semester 1/Week 5/Marlon Guanoluisa Journal Week 5.docx

Marlon A. Guanoluisa Pozo

- After discussed with all my group, some changes and layout were added to de graph and in the same time to save space, both armature resistance graphs were joined and in the same way the torque’s graph for the Motor Characterisation part in the DR1 draft, all this work were carried out along with Aarambh.
