EEEUoMgroup22/Group-22/Weekly Journal/Semester 1/Week 6/Marlon Guanoluisa Journal Week 6.docx

Marlon A. Guanoluisa Pozo

- I have helped Osama testing the TCRT5000, some mistakes were realised, and some improvements were made for testing the other sensors.
- After the suggestion made to improve our final DR1 and discussed with all the members of my group, I have put the captions in each graph for Motor Characterisation and tried to make our content more compact to don not exceed the limit of number of pages.
- I participated giving examples for our Risk Register, everyone ideas and examples were analysed and discussed.
- I have started doing some research for the Software part in our DR2, I have read the lecture notes to get an idea how this part should be done.
