EEEUoMgroup22/Group-22/Weekly Journal/Semester 1/Week 6/Osama Othman Weekly journal week6 .docx

- Researched a sensor trct5000 with a 10K resistor but I may need to repeat experiment due unsuitable light conditions
- Researched and made criteria for the sensors and underway on completing measurement procedures that must be done to obtain valid results that could be used to evaluate sensitivity under different test conditions.
- Completed my draft for dr1 presentation and submitted group report
- Completed the group risk register for the Embedded systems project semester 1 and 2
- Added my part of design and research needed for the line and non-line sensing circuits to Gantt chart
