EEEUoMgroup22/Group-22/Weekly Journal/Semester 1/Week 8/Aarambh Sinha week 8.docx

Aarambh Sinha:

- Completed sensor characterisation for all combination of sensors. This includes gathering data for the OPE5685 – SFH203, OPE5686 – BPW17N, OPE5685 – VT90N2, TCRT5000 and OVL5521 – VT90N2. By performing multiple tests, we ensured we had reproducible data that will be mirrored in real world situations. By reviewing the performance of all sensors, we decided to use the TCRT5000 sensor with a 10,000-ohm resistor to further our research and decision for use on the buggy.
- Started working on the sensor characterisation draft and performing statistical analysis on the measurements to check for percentage errors across all measurements.
- Designed the schematic for the sensor board. I used Eagle CAD as it is free and includes all the important libraries that consists of the correct components. The schematic allows the group to decide on how the sensors will physically interact with the microcontroller and how it is going to be connected. The group’s decision on the placement of sensors is now being applied by positioning the sensor and the PCB to fit the rest of the buggy.
