EEEUoMgroup22/Group-22/Weekly Journal/Semester 1/Week 8/Marlon Guanoluisa Journal Week 8.docx

Marlon Guanoluisa:

- I have attended to the High Voltage session where after the explanation provided by the experts of the project and some question asked, my group and I realise some risks and hazards that it could be experienced.
- I have make progress on the software part of the DR2, I have been working on: Context diagram and table of messages.
- I have made an sketch in 2D of the design of the chassis, just for give to my group another ideas about the design of our buggy.
