EEEUoMgroup22/Group-22/Weekly Journal/Semester 1/Week 8/Osama week 8 journal contribution.docx

- Helped Aram characterize the tcrt5000 10K sensor at three heights for line spread, check if the bpw works correctly and choose a resistor for the bpw
- Researched how non-line sensors work by reading pages 67 to 76 and watched online videos and articles about speed sensing using encoders and made relevant notes
- Started report draft with basic information
