EEEUoMgroup22/Group-22/Weekly Journal/Semester 1/Week 9/Abdullah week 9.docx

Abdullah Ahmed Akhtar

- Worked out dimensions for all the components to be placed on chassis, sizes of holes for boards and gearbox etc.
- Worked on solid works and completed two parts of chassis (as our chassis will have two layers) based on the initial design.
- Sketched another design on paper and then worked on this design on solid works to give us another option for the shape of the chassis.
- Started working on the written part of hardware overview section of the DR2 report and have written two pages so far and I am aiming to finish it by Tuesday.
- Cut two shapes out of paper, based on the two designs, to scale to give the group a precise idea of the length and width of the buggy.
