EEEUoMgroup22/Group-22/Weekly Journal/Semester 1/Week 9/Subhi journal wk9.docx

Subhi ALSous:

- Helped design the initial sensor design on Sunday along Aarambh and Osama by drawing the track and testing various implementations
- Completed most of my control algorithm section for the DR2 report and hopefully will finish by the mid of week 10
- Decided on the initial control implementation plan for next semester after studying the PID controller with greater detail
- Researched and understood how the motor drive board works within our system and what connections need to be made to interface with the microcontroller
