EEEUoMgroup22/Group-22/Weekly Journal/Semester 2/Week 2/Aarambh Sinha.docx

Aarambh Sinha

- Discussed with the group and agreed to complete the Technical Overview section with Abdullah. I will be focusing on Software System Design, Sensor Characterisation and Control Algorithms Section.
- I took the responsibility of the design and development of the sensor circuit implementation. I will be attending the allocated Circuit Development labs to ensure the correct processes are applied for the most effective design and manufacture.
- Made changes to the sensors circuit schematic so the sensors can operate at lower power with individual LED control.
