EEEUoMgroup22/Group-22/Weekly Journal/Semester 2/Week 2/Abdullah sem 2 week 2.docx

Abdullah Ahmed Akhtar

- Worked on the CAD design of the buggy using solidworks and assembled all the components on to the chassis, to present it in the proposal report.
- Created a new part in solid works to present the sensor circuit and added it to the assembly.
- As decided in the meeting I worked on the CAD design part of the introduction for proposal report and finished of writing my part for introduction.
- I was also working on technical overview section (chassis design, motor characterisation and winning features.) of the proposal report. To prepare for this I read DR1 and DR2 in detail and made key notes to mention in the proposal report.
- Started writing the technical overview, and finished writing the overview of chassis design, and stared working on the motor characterisation and winning features. I am hoping to finish this by Monday.
- As decided in the meeting I will focus on the hardware development section of the project and will attend the necessary labs.
