EEEUoMgroup22/Group-22/Weekly Journal/Semester 2/Week 3/Marlon Guanoluisa Week 3.docx

Marlon Guanoluisa:

- Checked and finished the section of Team Organisation that I was assigned for the Proposal Report.
- Attended to the labs along with Aarambh and Abdullah where we will be focusing on the Circuit and Hardware Development.
- Start to build and connect all parts to the chassis using screws and spacers.
- Peeled, soldered, and clipped the wires to the heads needed for the motors.
- Studied information about Motor Drive Board that is found in Blackboard to make sure where the wires should be connected to.
