EEEUoMgroup22/Group-22/Weekly Journal/Semester 2/Week 3/Subhi journal wk3.docx

Subhi Alsous:

- Finished up the introduction section of the proposal report
- Designed the gantt chart for semester 2 and wrote a brief description about the chart for the proposal report
- Attended both Software Development Labs with Osama in which we made progress in preparation for TD1
- Wrote a class for motor control and pwm, subject to testing
- Figured out the required pin connection for the microcontroller-driver board interface
