EEEUoMgroup22/Group-22/Weekly Journal/Semester 1/Week 2/week 1 journal .docx

Osama Othman, 10135442:

- Created a summary of the lab work experiment that will take place in the motor’s lab for my group’s members and shared it on the WhatsApp ESP group
- Read the 20 pages (20 to 40) explaining the motor’s lab tasks
- I summarized what I will do in detailed steps in the motor lab 10-minute role of force measurement and calculated the weights I will use in lab
- Had some difficulty understanding how to accurately measure the force to overcome static friction and rolling friction, even though the internet didn’t help, reading the lab description did and I understand that all Ill be using is force gauge.
