EEEUoMgroup22/Group-22/Weekly Journal/Semester 1/Week 2/WEEKLY JOURNAL draft Marlon G.docx

WEEKLY JOURNAL

Name: Marlon Guanoluisa

ID: 10145373

I proposed to use Dropbox to keep our documents about the project saved and organised. Everyone was agreed with this idea. Therefore, a Dropbox folder was created called “Group 22”. I will be in charge of it and it will keep updated.

In addition, I will be part of the first laboratory, Motor Control Laboratory, along with Abdullah and Subhi. Through this week I have been reading the Technical Handbook and doing a little of online researcher to prepare for it.
