EEEUoMgroup22/Group-22/Weekly Journal/Semester 1/Week 11/Marlon Guanoluisa Journal Week 11.docx

Marlon Guanoluisa

- I submitted the peer review.
- I attended to the ESP test.
- I have started reading and searching information for the Team organisation of the Proposal report.
