EEEUoMgroup22/Group-22/Weekly Journal/Semester 1/Week 11/Subhi Alsous week 11 .docx

Subhi Alsous:

- Researched and reviewed all embedded systems topics to prepare for the ESP quiz
- Finished and submitted the peer review by filling out the form and answering all the required questions
- I got assigned the gantt chart of the second semester along with some help from Osama, in which I should work on and submit at the beginning of next semester
- For the proposal report, I am responsible for doing the introduction section with listing all objectives and deliverables.
