EEEUoMgroup22/Group-22/Weekly Journal/Semester 1/Week 11/week 11 abdullah.docx

Abdullah AhmedAkhtar

- Submitted the Peer review form on blackboard .
- Sat the ESP test in Barnes Wallis.
- Had initial discussion about proposal report on WhatsApp.
- Decided in meeting that I will work with Arambh on technical overview section of proposal report.
- Had a look at the proposal report mark scheme in the procedures handbook.
