EEEUoMgroup22/Group-22/Weekly Journal/Semester 1/Week 11/Weekly journal week 11.docx

Week 11 Group 22 Journal

Date: 21/10/18

1. Action items from last week
- After conversing on our group chat online, we agreed who will do what section in the proposal report:
  - Introduction : Aarambh
  - Marlon : Planning and Budget
  - Technical Overview Osama and Subhi
  - Abdullah Team organisation

However these aren’t final but are just so that everyone can check if he is able to do that section

2. Project Status and statement of progress

Now the group will start to work on planning for the proposal who will do which parts of it on Monday (10/12/2018) and Wednesday (12/12). On Monday we will also reflect on any mistakes that we have done and lay down some ground rules to prevent them. Finally, we will start our work on the final engineering management assignment Review of proposed engineering project contract.

3. Individual Student Contributions

Osama Othman:

- Submitted the Peer Review form on blackboard.
- Took the ESP test in Barnes Wallis.
- Had initial discussion about proposal report on WhatsApp and have decided to do half of the planning and budget and will help Subhi wiath gantt charts.
- Wrote the Weekly report for the group with Aarambh.

Marlon Guanoluisa:

- I submitted the peer review.
- I attended the ESP test.
- I have started reading and searching information for the Team organisation of the Proposal report.

Subhi Alsous:

- Researched and reviewed all embedded systems topics to prepare for the ESP quiz
- Finished and submitted the peer review by filling out the form and answering all the required questions
- I got assigned the gantt chart of the second semester along with some help from Osama, in which I should work on and submit at the beginning of next semester
- For the proposal report, I am responsible for doing the introduction section with listing all objectives and deliverables.

Aarambh Sinha:

- Completed the sensors and implementation section of DR2
- Did final proofread and final checks before submission of DR2
- Completed peer review of the rest of the group members.
- Sat the ESP test in Barnes Wallis.
- I will focus on the Technical Overview section with Abdullah. Will cover software design, sensor characterisation and control algorithms selections.

Abdullah Ahmed Akhtar:

- Submitted the Peer review form on blackboard .
- Sat the ESP test in Barnes Wallis.
- Had initial discussion about proposal report on WhatsApp.
- Decided in meeting that I will work with Aarambh on technical overview section of proposal report.
- Had a look at the proposal report mark scheme in the procedure’s handbook.
