EEEUoMgroup22/Group-22/Weekly Journal/Semester 1/Week 5/abdullah weekly journal.docx

Abdullah Ahmed Akhtar

- Put my results from load measurement experiment onto a spreadsheet and uploaded onto dropbox.
- Finished writing introduction of DR1 report.
- After discussing with team members, made necessary changes to my section of the DR1 report.
- Regarding DR2 report I took the responsibility to work on “hardware overview” section of the report, and therefore I have read page 84 of the technical handbook, and made some notes.
