EEEUoMgroup22/Group-22/Weekly Journal/Semester 1/Week 6/Abdullah veekly journal week 6.docx

Abdullah Ahmed Akhtar

- Worked on the final draft of DR1 report and made the necessary changes, to my part, after discussing in the team. This included adding caption to the figure, removing bullet points and writing in paragraph etc.
- Participated in the discussion with team and gave examples of risks associated with our ESP project.
- I have started my research for ‘’hardware overview’’ section of the DR2 report and have read pages 26-29 of the procedures handbook to improve my understanding of what I’m required to do for this task.
