EEEUoMgroup22/Group-22/Weekly Journal/Semester 1/Week 7/Marlon Guanoluisa Journal Week 7.docx

Marlon Guanoluisa

- I have written the draft for the Functional summary in the Software part of the DR2.
- I have made notes for the possible software constraints that will be experienced. However, there are some issues that I will put into consideration and discussion in the next group’s meeting.
- For the context diagram, I have started making notes and sketches.
