EEEUoMgroup22/Group-22/Weekly Journal/Semester 1/Week 2/Aarambh Sinha Weekly Journal WK2.docx

Aarambh Sinha

10163290

Our initial meeting (Thursday Week 2) involved deciding which lab session each person felt the most comfortable with, I decided to partake in the Sensors lab with Osama

In response to the meeting, we had an agreement that we will make use of Github for our repository of code and documentation. We agreed using a version control system like GitHub will ensure our code is always readily available with multiple redundant backups of previous versions of code. This ensures that we can always push out working code even if there are open bugs in newer versions of the code.

In order to set up our repository, I instructed my team members to create independent accounts for GitHub and synchronise the repository to their desktops.

The repository can be found on :

https://github.com/EEEUoMgroup22

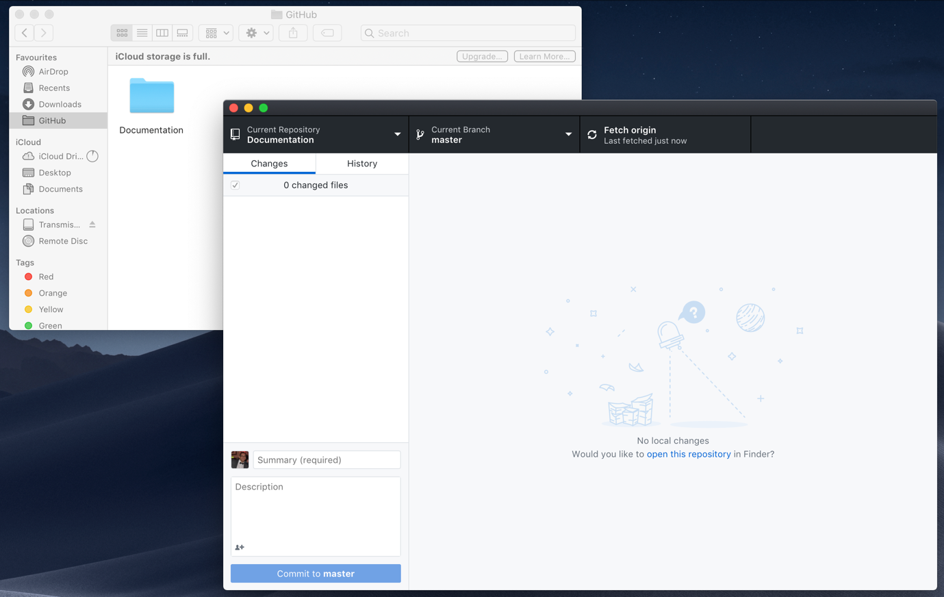
[picture p105: figure]
