EEEUoMgroup22/Group-22/Weekly Journal/Semester 1/Week 2/week 1 abdullah.docx

Abdullah Ahmed Akhtar

In the meeting it was decided that I would attend the motor lab along with Marlon and Subhi.

To prepare for this lab, I have gone through the technical handbook (pg. 20-40), highlighting the necessary equations and information that I would require while doing the lab. I have also gone through procedures handbook to understand and clarify how project will work, e.g. weekly journal, how we will be marked etc.
