EEEUoMgroup22/Group-22/Measurements/Motors and Gearbox Results/results from force measurement (Aarambh's changes b'2018-10-15').xlsx

weight (N) | Flat:stationary (N) | Flat: constant speed (N) | Ramp: stationary | Ramp: constant speed | coffient of static friction: flat stationary | coffient of rolling friction flat constant | Ramp: static friction coffient | Ramp: rolling friction coffient
5.5 | 0.5 | 0.5 | 3 | 2.2 | 0.100 | 0.0909 | 0.3071511762 | 0.1373164714
5.5 | 0.6 | 0.5 | 3.2 | 2.2 |  | 0.1182 | 0.6845616315 | 0.3071511762
10.5 | 1.2 | 0.8 | 7 | 4 | 0.105 | 0.0762 | 0.4140841386 | 0.1175473523
10.5 | 1 | 0.8 | 7 | 4 |  | 0.0857 | 0.6611981271 | 0.2163929477
15.5 | 1.3 | 1 | 12 | 6 | 0.087 | 0.0710 | 0.5256840043 | 0.1239244875
15.5 | 1.4 | 1.2 | 12 | 6 |  | 0.1032 | 0.6093839037 | 0.190884407
20.5 | 1.7 | 2 | 14.5 | 8 | 0.078 | 0.0902 | 0.4562743317 | 0.127190825
20.5 | 1.5 | 1.7 | 14.5 | 8 |  | 0.0415 | 0.08921965119 | -0.07532210215
AVERAGE FRICTION |  |  |  |  | 0.092 | 0.082 | 0.426 | 0.126
TORQUE REQUIRED FOR MASS OF 1217g |  |  |  |  | 0.046 | 0.041 | 0.336 | 0.193
Degree in degrees | 15.5
Diameter | 8.3 cm
