EEEUoMgroup22/Group-22/(list of files, drawings)

Other design files:
Measurements/Sensors Methods and Results/Design1.ms14
Schematic + PCB Design/FinalisedAnalogueSensors/ESP SENSOR/ANALOGUESENSOR.PrjPcb
Schematic + PCB Design/FinalisedAnalogueSensors/ESP SENSOR/Integrated_Library/School Library.PcbLib
Schematic + PCB Design/FinalisedAnalogueSensors/ESP SENSOR/Integrated_Library/School Library.SchLib
Schematic + PCB Design/FinalisedAnalogueSensors/ESP SENSOR/PCB1.PcbDoc
Schematic + PCB Design/FinalisedAnalogueSensors/ESP SENSOR/Sheet1.SchDoc
Schematic + PCB Design/PCB2.PcbDoc
Schematic + PCB Design/PCB_Project.PrjPcb
Schematic + PCB Design/Sheet1.SchDoc
