EEEUoMgroup22/Group-22/(commit log)

2019-02-15 february changes
    [Budget for Proposal.xlsx, Design1.ms14, Graphs%20(1) stalled.xlsx, Graphs%20(1).xlsx, Graphs.xlsx, Marlon activities Osama asked.xlsx, OPE5685 SFH203 FINAL MEASUREMENTS.xlsx, OVL -vt90n2.xlsx]
2019-03-11 updated tech demo files
    [ANALOGUESENSOR.PrjPcb, PCB1.PcbDoc, School Library.PcbLib, School Library.SchLib, Sheet1.SchDoc]
